asinghani/ibm-5151-controller/README.md

# IBM 5151 Controller

Building a VT100 emulator out of an old IBM 5151 monitor and an FPGA
