asinghani/ibm-5151-controller/pcb/3d/front.png

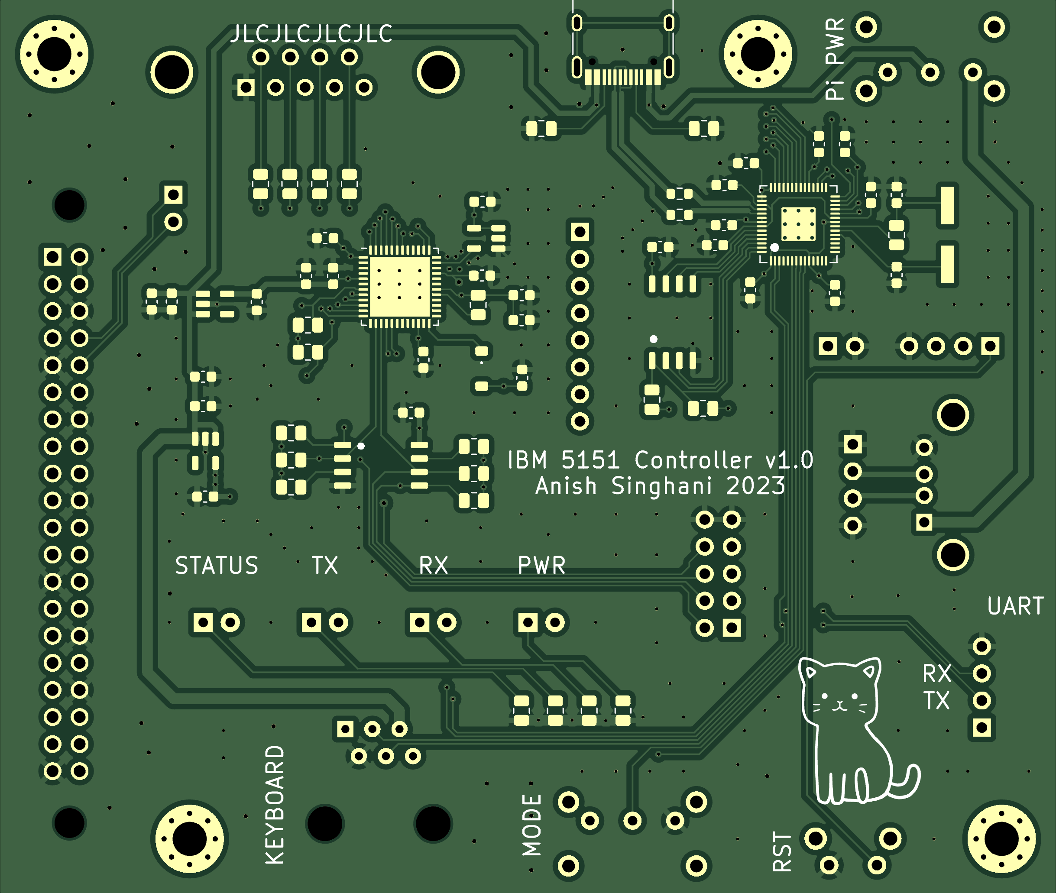
pcb/3d/front.png
