asinghani/ibm-5151-controller/pcb/3d/rear.png

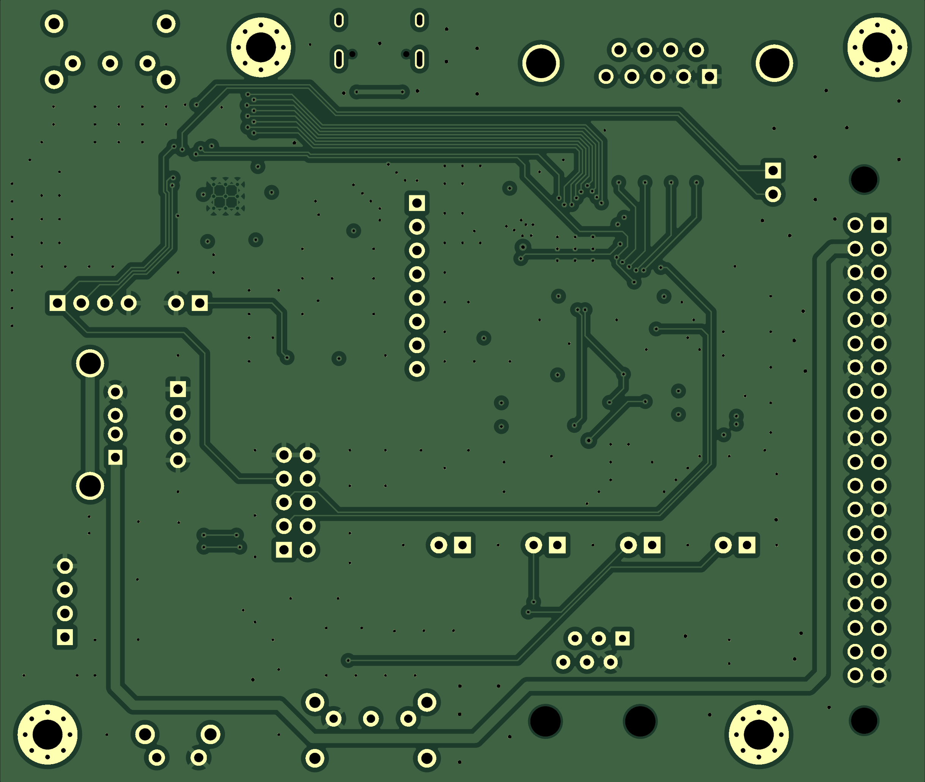
pcb/3d/rear.png
