asinghani/ibm-5151-controller/pcb/parts/Amphenol_54601/Amphenol_54601.STEP

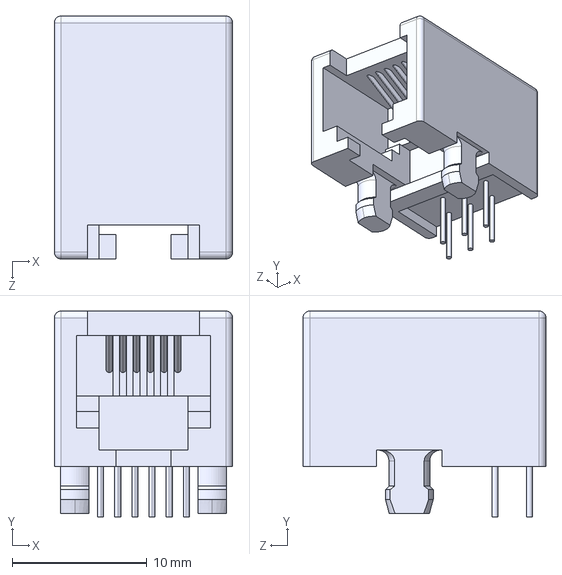
[picture p3: CAD file, 2023-10-15]
pcb/parts/Amphenol_54601/Amphenol_54601.STEP
13.2 x 15.2 x 18.0 mm
