asinghani/ibm-5151-controller/pcb/parts/ECS-120-20-3X-TR/ECS-120-20-3X-TR.step

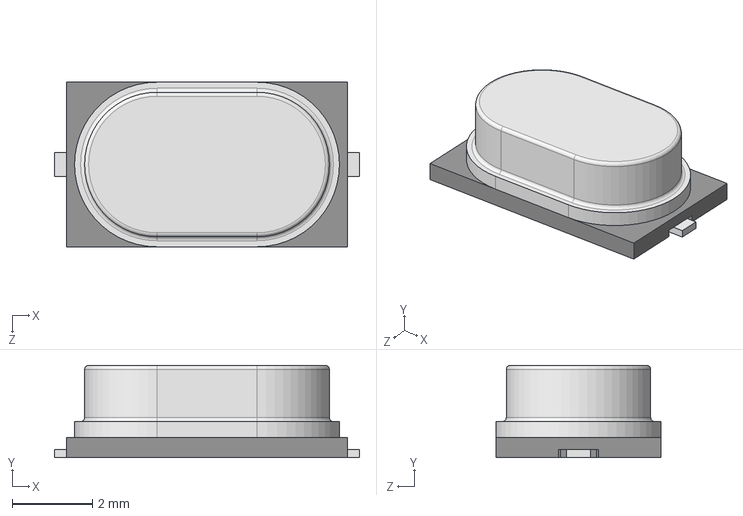
[picture p4: CAD file, 2023-10-15]
pcb/parts/ECS-120-20-3X-TR/ECS-120-20-3X-TR.step
7.60 x 2.30 x 4.10 mm
