asinghani/ibm-5151-controller/pcb/parts/Raspberry_Pi_Zero_W/RaspberryPiZeroW.STEP

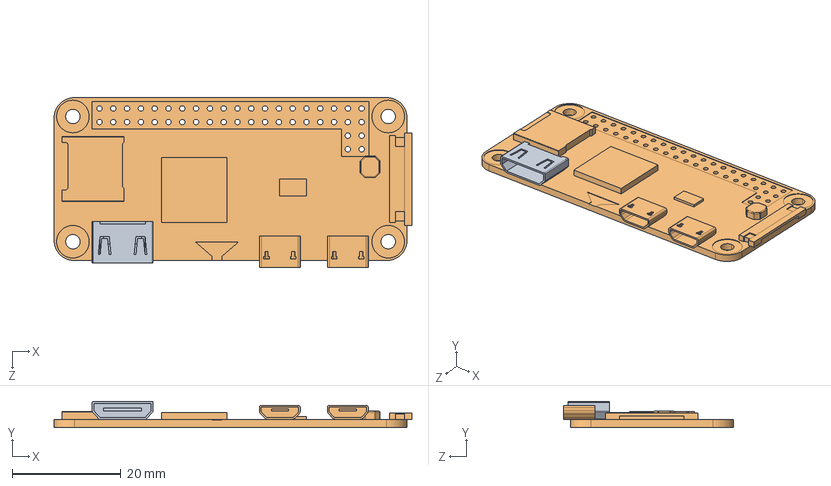
[picture p5: CAD file, 2023-10-15]
pcb/parts/Raspberry_Pi_Zero_W/RaspberryPiZeroW.STEP
65.9 x 4.80 x 31.2 mm
