asinghani/ibm-5151-controller/experimental/fonts/all_chars.png

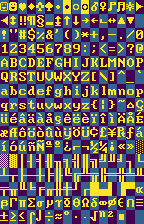
experimental/fonts/all_chars.png
