asinghani/ibm-5151-controller/experimental/fonts/all_chars_inv.png

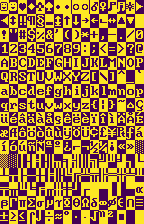
experimental/fonts/all_chars_inv.png
