asinghani/ibm-5151-controller/experimental/fonts/cow.png

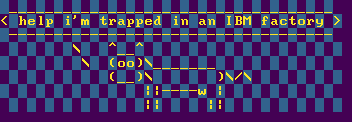
experimental/fonts/cow.png
