asinghani/ibm-5151-controller/gateware/chisel/tests/image1.png

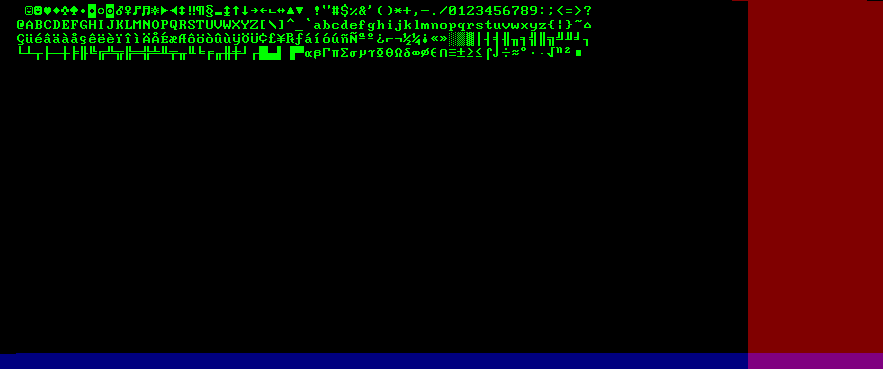
gateware/chisel/tests/image1.png
