asinghani/ibm-5151-controller/pcb/ibm-5151-pcb.kicad_pcb

## KiCad design pcb/ibm-5151-pcb.kicad_pcb (2023-12-21)

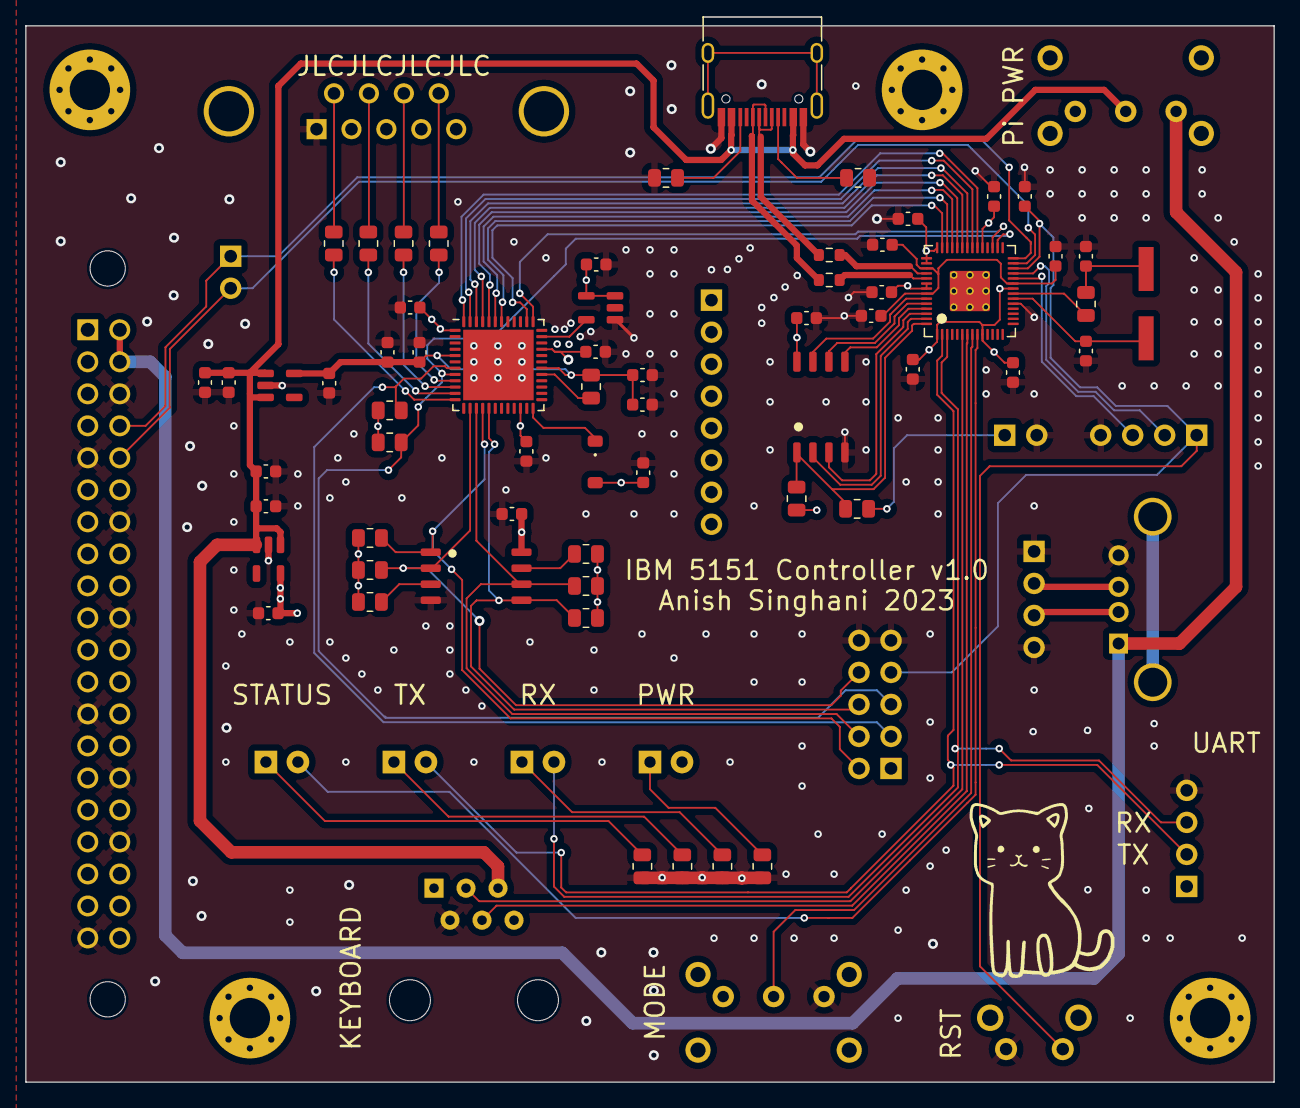
[picture p10: board ibm-5151-pcb.kicad_pcb from above]

Board: 4 copper layers, 99.1 x 83.8 mm, 84 parts (0 on the bottom side), 67 nets.

Parts:
C1, C2, C13: 10u; C_0603_1608Metric
C3, C4, C5, C6, C22, C26: 1u; C_0603_1608Metric
C7, C8, C9, C10, C11, C12, C15, C16, C20, C21, C23, C24, C25, C27, C28: 100n; C_0603_1608Metric
C14: 10n; C_0603_1608Metric
C17, C18: 27p; C_0603_1608Metric
C19: 0.1u; C_0603_1608Metric
D1: MBR130; D_SOD-123
D2: RXLED; LED_D5.0mm
D3: TXLED; LED_D5.0mm
D4: STLED; LED_D5.0mm
D5: PWRLED; LED_D5.0mm
H1, H2, H3, H4: MountingHole; MountingHole_3.2mm_M3_Pad_Via
IC1: Raspberry Pi Zero W; RASPBERRYPIZEROWV13
J2: USB_USER; USB_C_Receptacle_HRO_TYPE-C-31-M-12
J3: BOOT; PinHeader_1x02_P2.54mm_Vertical
J4: RP_DEBUG; PinHeader_1x04_P2.54mm_Vertical
J5: FPGA_IF_TP; PinHeader_1x08_P2.54mm_Vertical
J6: UART_HDR; PinSocket_1x04_P2.54mm_Horizontal
J7: KBD_CONN; RJ12_Amphenol_54601
J8: DE9_Receptacle; DSUB-9_Female_Horizontal_P2.77x2.84mm_EdgePinOffset7.70mm_H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
J9: NET_DBG; PinHeader_1x02_P2.54mm_Vertical
J10: USB_A; USB_A_Molex_67643_Horizontal
J11: USB_HDR; PinHeader_1x04_P2.54mm_Vertical
J12: FPGA_DEBUG; PinHeader_2x05_P2.54mm_Vertical
R1, R2, R3, R4, R5, R6: 10K; R_0805_2012Metric
R7, R8: 2K2; R_0805_2012Metric
R9, R21, R22, R23: 10R; R_0805_2012Metric
R10, R11: 5K1; R_0805_2012Metric
R12, R14, R17, R18, R19, R20: 1k; R_0805_2012Metric
R13: 10k, DNF; R_0805_2012Metric
R15, R16: 27R; R_0603_1608Metric
R24: 100R; R_0805_2012Metric
SW1: RP_RST; SW_Tactile_SPST_Angled_PTS645Vx58-2LFS
SW2, SW3: SW_SPDT; SW_E-Switch_EG1224_SPDT_Angled
U1: MIC5504-1.2YM5; SOT-23-5
U2: MIC5504-3.3YM5; SOT-23-5
U3: W25Q32JVSS; SOIC-8_5.23x5.23mm_P1.27mm
U4: W25Q128JVS; SOIC-8_5.23x5.23mm_P1.27mm
U5: ICE40UP5K-SG48ITR; QFN-48-1EP_7x7mm_P0.5mm_EP5.6x5.6mm
U6: RP2040; RP2040-QFN-56
X1: SiT2001BI-S2-33E-12.000000G; SOT-23-5
Y1: ECS-120-20-3X-TR; XTAL_ECS-120-20-3X-TR

Connections:
+1V2: C5.1, C12.1, C13.1, C14.1, C15.1, R24.2, U1.5 (VOUT), U5.5 (VCC), U5.30 (VCC)
+3V3: C6.1, C7.2, C8.1, C9.1, C10.1, C11.1, C16.1, C23.1, C24.1, C25.1, C26.1, C27.1, C28.2, D1.2 (A), D5.2 (A), J6.1, J12.1, R1.1, R2.1, R3.1, R4.1, R5.1, R6.1, R7.1, R8.1, R13.1, SW2.1 (A), U2.5 (VOUT), U3.8 (VCC), U4.8 (VCC), U5.1 (VCCIO_2), U5.22 (SPI_VCCIO1), U5.33 (VCCIO_0), U6.1 (IOVDD), U6.10 (IOVDD), U6.22 (IOVDD), U6.33 (IOVDD), U6.42 (IOVDD), U6.43 (ADC_AVDD), U6.44 (VREG_IN), U6.48 (USB_VDD), U6.49 (IOVDD), X1.3 (OE), X1.4 (Vcc)
+5V: C1.1, C2.1, C3.1, C4.1, J2.A4 (VBUS), J2.A9 (VBUS), J2.B4 (VBUS), J2.B9 (VBUS), J7.5, SW3.2 (B), U1.1 (VIN), U1.3 (EN), U2.1 (VIN), U2.3 (EN)
FPGA_CSn: J12.2, R1.2, U3.1 (~CS), U5.16 (IOB_35b_SPI_SS)
FPGA_DONE: J12.3, R8.2, U5.7 (CDONE)
FPGA_IF_0: J5.1, U5.48 (IOB_4a), U6.34 (GPIO22)
FPGA_IF_1: J5.2, U5.47 (IOB_2a), U6.35 (GPIO23)
FPGA_IF_2: J5.3, U5.46 (IOB_0a), U6.36 (GPIO24)
FPGA_IF_3: J5.4, U5.45 (IOB_5b), U6.37 (GPIO25)
FPGA_IF_4: J5.5, U5.44 (IOB_3b_G6), U6.38 (GPIO26_ADC0)
FPGA_IF_5: J5.6, U5.43 (IOT_49a), U6.39 (GPIO27_ADC1)
FPGA_IF_6: J5.7, U5.42 (IOT_51a), U6.40 (GPIO28_ADC2)
FPGA_IF_7: J5.8, U5.38 (IOT_50b), U6.41 (GPIO29_ADC3)
FPGA_IF_RST: U5.37 (IOT_45a_G1), U6.31 (GPIO20)
FPGA_MISO: J12.8, R4.2, U3.2 (DO(IO1)), U5.14 (IOB_32a_SPI_SO)
FPGA_MOSI: J12.6, R3.2, U3.5 (DI(IO0)), U5.17 (IOB_33b_SPI_SI)
FPGA_OSC: U5.35 (IOT_46b_G0), X1.5 (OUT)
FPGA_RSTn: J12.5, R7.2, U5.8 (~CRESET), U6.30 (GPIO19)
FPGA_SCK: J12.4, R2.2, U3.6 (CLK), U5.15 (IOB_34a_SPI_SCK)
GND: C1.2, C2.2, C3.2, C4.2, C5.2, C6.2, C7.1, C8.2, C9.2, C10.2, C11.2, C12.2, C13.2, C14.2, C15.2, C16.2, C17.2, C18.2, C19.2, C20.2, C21.2, C22.2, C23.2, C24.2, C25.2, C26.2, C27.2, C28.1, IC1.6 (GND_1), IC1.9 (GND_2), IC1.14 (GND_3), IC1.20 (GND_4), IC1.25 (GND_5), IC1.30 (GND_6), IC1.34 (GND_7), IC1.39 (GND_8), J2.A1 (GND), J2.A12 (GND), J2.B1 (GND), J2.B12 (GND), J3.2, J4.4, J6.4, J7.2, J8.1, J8.2, J10.4 (GND), J11.1, J11.4, J12.9, J12.10, R10.2, R11.2, R17.2, R18.2, R19.2, R20.2, SW1.2, SW2.3 (C), U1.2 (GND), U2.2 (GND), U3.4 (GND), U4.4 (GND), U5.49 (GND), U6.19 (TESTEN), U6.57 (GND), X1.1 (GND)
KBD_RX: J7.4, U6.7 (GPIO5)
KBD_TX: J7.3, U6.6 (GPIO4)
LED_STATUS: D4.2 (A), U6.9 (GPIO7)
NET_RX: IC1.8 (GPIO_14/[UART]_TXD0), J9.1, U6.28 (GPIO17)
NET_TX: IC1.10 (GPIO_15/[UART]_RXD0), J9.2, U6.27 (GPIO16)
unnamed: C18.1, R14.2, Y1.2
unnamed: D1.1 (K), U5.24 (VPP_2V5)
unnamed: D2.1 (K), R17.1
unnamed: D3.1 (K), R18.1
unnamed: D4.1 (K), R19.1
unnamed: D5.1 (K), R20.1
unnamed: J2.A5 (CC1), R10.1
unnamed: J2.B5 (CC2), R11.1
unnamed: J8.6, R9.2
unnamed: J8.7, R21.2
unnamed: J8.8, R22.2
unnamed: J8.9, R23.2
unnamed: J10.3 (D+), J11.2
unnamed: J10.2 (D-), J11.3
unnamed: R5.2, U3.3 (IO2)
unnamed: R6.2, U3.7 (IO3)
unnamed: R24.1, U5.29 (VCCPLL)
unnamed: R16.2, U6.46 (USB_DM)
unnamed: R15.2, U6.47 (USB_DP)
unnamed: C20.1, C21.1, C22.1, U6.23 (DVDD), U6.45 (VREG_VOUT), U6.50 (DVDD)
unnamed: C17.1, U6.20 (XIN), Y1.1
unnamed: R14.1, U6.21 (XOUT)
RP_BOOT: J3.1, R12.1
RP_CSn: R12.2, R13.2, U4.1 (~CS), U6.56 (QSPI_SS)
RP_RSTn: C19.1, J4.1, J12.7, SW1.1, U6.26 (RUN)
RP_SCK: U4.6 (CLK), U6.52 (QSPI_SCLK)
RP_SD0: U4.5 (DI(IO0)), U6.53 (QSPI_SD0)
RP_SD1: U4.2 (DO(IO1)), U6.55 (QSPI_SD1)
RP_SD2: U4.3 (IO2), U6.54 (QSPI_SD2)
RP_SD3: U4.7 (IO3), U6.51 (QSPI_SD3)
SWCLK: J4.3, U6.24 (SWCLK)
SWDIO: J4.2, U6.25 (SWD)
SW_SEL: SW2.2 (B), U6.8 (GPIO6)
UART_RX: D2.2 (A), J6.3, U6.3 (GPIO1)
UART_TX: D3.2 (A), J6.2, U6.2 (GPIO0)
USB_N: J2.A7 (D-), J2.B7 (D-), R16.1
USB_P: J2.A6 (D+), J2.B6 (D+), R15.1
USB_PWR: IC1.2 (+5V_1), IC1.4 (+5V_2), J10.1 (VBUS), SW3.1 (A)
VIDEO_HSYNC: R22.1, U5.10 (IOB_18a)
VIDEO_INTENS: R9.1, U5.12 (IOB_22a)
VIDEO_PIXEL: R21.1, U5.11 (IOB_20a)
VIDEO_VSYNC: R23.1, U5.9 (IOB_16a)
