asinghani/ibm-5151-controller/experimental/font.sv

module font (
    input logic [3:0] xidx,
    input logic [3:0] yidx,
    input logic [7:0] char,
    output logic pixel
);

    always_comb begin
        case (char)
            8'd32: pixel = 0;
            8'd33: pixel = ((xidx==3)&&(yidx==2))||((xidx==4)&&(yidx==2))||((xidx==2)&&(yidx==3))||((xidx==3)&&(yidx==3))||((xidx==4)&&(yidx==3))||((xidx==5)&&(yidx==3))||((xidx==2)&&(yidx==4))||((xidx==3)&&(yidx==4))||((xidx==4)&&(yidx==4))||((xidx==5)&&(yidx==4))||((xidx==2)&&(yidx==5))||((xidx==3)&&(yidx==5))||((xidx==4)&&(yidx==5))||((xidx==5)&&(yidx==5))||((xidx==3)&&(yidx==6))||((xidx==4)&&(yidx==6))||((xidx==3)&&(yidx==7))||((xidx==4)&&(yidx==7))||((xidx==3)&&(yidx==9))||((xidx==4)&&(yidx==9))||((xidx==3)&&(yidx==10))||((xidx==4)&&(yidx==10));
            8'd34: pixel = ((xidx==1)&&(yidx==1))||((xidx==2)&&(yidx==1))||((xidx==6)&&(yidx==1))||((xidx==7)&&(yidx==1))||((xidx==1)&&(yidx==2))||((xidx==2)&&(yidx==2))||((xidx==6)&&(yidx==2))||((xidx==7)&&(yidx==2))||((xidx==1)&&(yidx==3))||((xidx==2)&&(yidx==3))||((xidx==6)&&(yidx==3))||((xidx==7)&&(yidx==3))||((xidx==2)&&(yidx==4))||((xidx==6)&&(yidx==4));
            8'd35: pixel = ((xidx==2)&&(yidx==2))||((xidx==3)&&(yidx==2))||((xidx==5)&&(yidx==2))||((xidx==6)&&(yidx==2))||((xidx==2)&&(yidx==3))||((xidx==3)&&(yidx==3))||((xidx==5)&&(yidx==3))||((xidx==6)&&(yidx==3))||((xidx==1)&&(yidx==4))||((xidx==2)&&(yidx==4))||((xidx==3)&&(yidx==4))||((xidx==4)&&(yidx==4))||((xidx==5)&&(yidx==4))||((xidx==6)&&(yidx==4))||((xidx==7)&&(yidx==4))||((xidx==2)&&(yidx==5))||((xidx==3)&&(yidx==5))||((xidx==5)&&(yidx==5))||((xidx==6)&&(yidx==5))||((xidx==2)&&(yidx==6))||((xidx==3)&&(yidx==6))||((xidx==5)&&(yidx==6))||((xidx==6)&&(yidx==6))||((xidx==2)&&(yidx==7))||((xidx==3)&&(yidx==7))||((xidx==5)&&(yidx==7))||((xidx==6)&&(yidx==7))||((xidx==1)&&(yidx==8))||((xidx==2)&&(yidx==8))||((xidx==3)&&(yidx==8))||((xidx==4)&&(yidx==8))||((xidx==5)&&(yidx==8))||((xidx==6)&&(yidx==8))||((xidx==7)&&(yidx==8))||((xidx==2)&&(yidx==9))||((xidx==3)&&(yidx==9))||((xidx==5)&&(yidx==9))||((xidx==6)&&(yidx==9))||((xidx==2)&&(yidx==10))||((xidx==3)&&(yidx==10))||((xidx==5)&&(yidx==10))||((xidx==6)&&(yidx==10));
            8'd36: pixel = ((xidx==4)&&(yidx==0))||((xidx==5)&&(yidx==0))||((xidx==4)&&(yidx==1))||((xidx==5)&&(yidx==1))||((xidx==2)&&(yidx==2))||((xidx==3)&&(yidx==2))||((xidx==4)&&(yidx==2))||((xidx==5)&&(yidx==2))||((xidx==6)&&(yidx==2))||((xidx==1)&&(yidx==3))||((xidx==2)&&(yidx==3))||((xidx==6)&&(yidx==3))||((xidx==7)&&(yidx==3))||((xidx==1)&&(yidx==4))||((xidx==2)&&(yidx==4))||((xidx==7)&&(yidx==4))||((xidx==1)&&(yidx==5))||((xidx==2)&&(yidx==5))||((xidx==2)&&(yidx==6))||((xidx==3)&&(yidx==6))||((xidx==4)&&(yidx==6))||((xidx==5)&&(yidx==6))||((xidx==6)&&(yidx==6))||((xidx==6)&&(yidx==7))||((xidx==7)&&(yidx==7))||((xidx==1)&&(yidx==8))||((xidx==6)&&(yidx==8))||((xidx==7)&&(yidx==8))||((xidx==1)&&(yidx==9))||((xidx==2)&&(yidx==9))||((xidx==6)&&(yidx==9))||((xidx==7)&&(yidx==9))||((xidx==2)&&(yidx==10))||((xidx==3)&&(yidx==10))||((xidx==4)&&(yidx==10))||((xidx==5)&&(yidx==10))||((xidx==6)&&(yidx==10))||((xidx==4)&&(yidx==11))||((xidx==5)&&(yidx==11))||((xidx==4)&&(yidx==12))||((xidx==5)&&(yidx==12));
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
            8'd72: pixel = ((xidx==1)&&(yidx==2))||((xidx==2)&&(yidx==2))||((xidx==6)&&(yidx==2))||((xidx==7)&&(yidx==2))||((xidx==1)&&(yidx==3))||((xidx==2)&&(yidx==3))||((xidx==6)&&(yidx==3))||((xidx==7)&&(yidx==3))||((xidx==1)&&(yidx==4))||((xidx==2)&&(yidx==4))||((xidx==6)&&(yidx==4))||((xidx==7)&&(yidx==4))||((xidx==1)&&(yidx==5))||((xidx==2)&&(yidx==5))||((xidx==6)&&(yidx==5))||((xidx==7)&&(yidx==5))||((xidx==1)&&(yidx==6))||((xidx==2)&&(yidx==6))||((xidx==3)&&(yidx==6))||((xidx==4)&&(yidx==6))||((xidx==5)&&(yidx==6))||((xidx==6)&&(yidx==6))||((xidx==7)&&(yidx==6))||((xidx==1)&&(yidx==7))||((xidx==2)&&(yidx==7))||((xidx==6)&&(yidx==7))||((xidx==7)&&(yidx==7))||((xidx==1)&&(yidx==8))||((xidx==2)&&(yidx==8))||((xidx==6)&&(yidx==8))||((xidx==7)&&(yidx==8))||((xidx==1)&&(yidx==9))||((xidx==2)&&(yidx==9))||((xidx==6)&&(yidx==9))||((xidx==7)&&(yidx==9))||((xidx==1)&&(yidx==10))||((xidx==2)&&(yidx==10))||((xidx==6)&&(yidx==10))||((xidx==7)&&(yidx==10));
            8'd73: pixel = ((xidx==2)&&(yidx==2))||((xidx==3)&&(yidx==2))||((xidx==4)&&(yidx==2))||((xidx==5)&&(yidx==2))||((xidx==3)&&(yidx==3))||((xidx==4)&&(yidx==3))||((xidx==3)&&(yidx==4))||((xidx==4)&&(yidx==4))||((xidx==3)&&(yidx==5))||((xidx==4)&&(yidx==5))||((xidx==3)&&(yidx==6))||((xidx==4)&&(yidx==6))||((xidx==3)&&(yidx==7))||((xidx==4)&&(yidx==7))||((xidx==3)&&(yidx==8))||((xidx==4)&&(yidx==8))||((xidx==3)&&(yidx==9))||((xidx==4)&&(yidx==9))||((xidx==2)&&(yidx==10))||((xidx==3)&&(yidx==10))||((xidx==4)&&(yidx==10))||((xidx==5)&&(yidx==10));
            8'd74: pixel = ((xidx==4)&&(yidx==2))||((xidx==5)&&(yidx==2))||((xidx==6)&&(yidx==2))||((xidx==7)&&(yidx==2))||((xidx==5)&&(yidx==3))||((xidx==6)&&(yidx==3))||((xidx==5)&&(yidx==4))||((xidx==6)&&(yidx==4))||((xidx==5)&&(yidx==5))||((xidx==6)&&(yidx==5))||((xidx==5)&&(yidx==6))||((xidx==6)&&(yidx==6))||((xidx==5)&&(yidx==7))||((xidx==6)&&(yidx==7))||((xidx==1)&&(yidx==8))||((xidx==2)&&(yidx==8))||((xidx==5)&&(yidx==8))||((xidx==6)&&(yidx==8))||((xidx==1)&&(yidx==9))||((xidx==2)&&(yidx==9))||((xidx==5)&&(yidx==9))||((xidx==6)&&(yidx==9))||((xidx==2)&&(yidx==10))||((xidx==3)&&(yidx==10))||((xidx==4)&&(yidx==10))||((xidx==5)&&(yidx==10));
            8'd75: pixel = ((xidx==1)&&(yidx==2))||((xidx==2)&&(yidx==2))||((xidx==3)&&(yidx==2))||((xidx==6)&&(yidx==2))||((xidx==7)&&(yidx==2))||((xidx==2)&&(yidx==3))||((xidx==3)&&(yidx==3))||((xidx==6)&&(yidx==3))||((xidx==7)&&(yidx==3))||((xidx==2)&&(yidx==4))||((xidx==3)&&(yidx==4))||((xidx==5)&&(yidx==4))||((xidx==6)&&(yidx==4))||((xidx==2)&&(yidx==5))||((xidx==3)&&(yidx==5))||((xidx==5)&&(yidx==5))||((xidx==6)&&(yidx==5))||((xidx==2)&&(yidx==6))||((xidx==3)&&(yidx==6))||((xidx==4)&&(yidx==6))||((xidx==5)&&(yidx==6))||((xidx==2)&&(yidx==7))||((xidx==3)&&(yidx==7))||((xidx==5)&&(yidx==7))||((xidx==6)&&(yidx==7))||((xidx==2)&&(yidx==8))||((xidx==3)&&(yidx==8))||((xidx==5)&&(yidx==8))||((xidx==6)&&(yidx==8))||((xidx==2)&&(yidx==9))||((xidx==3)&&(yidx==9))||((xidx==6)&&(yidx==9))||((xidx==7)&&(yidx==9))||((xidx==1)&&(yidx==10))||((xidx==2)&&(yidx==10))||((xidx==3)&&(yidx==10))||((xidx==6)&&(yidx==10))||((xidx==7)&&(yidx==10));
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
            8'd95: pixel = ((xidx==0)&&(yidx==12))||((xidx==1)&&(yidx==12))||((xidx==2)&&(yidx==12))||((xidx==3)&&(yidx==12))||((xidx==4)&&(yidx==12))||((xidx==5)&&(yidx==12))||((xidx==6)&&(yidx==12))||((xidx==7)&&(yidx==12));
            8'd96: pixel = ((xidx==3)&&(yidx==0))||((xidx==4)&&(yidx==0))||((xidx==3)&&(yidx==1))||((xidx==4)&&(yidx==1))||((xidx==4)&&(yidx==2))||((xidx==5)&&(yidx==2));
            8'd97: pixel = ((xidx==2)&&(yidx==5))||((xidx==3)&&(yidx==5))||((xidx==4)&&(yidx==5))||((xidx==5)&&(yidx==5))||((xidx==5)&&(yidx==6))||((xidx==6)&&(yidx==6))||((xidx==2)&&(yidx==7))||((xidx==3)&&(yidx==7))||((xidx==4)&&(yidx==7))||((xidx==5)&&(yidx==7))||((xidx==6)&&(yidx==7))||((xidx==1)&&(yidx==8))||((xidx==2)&&(yidx==8))||((xidx==5)&&(yidx==8))||((xidx==6)&&(yidx==8))||((xidx==1)&&(yidx==9))||((xidx==2)&&(yidx==9))||((xidx==5)&&(yidx==9))||((xidx==6)&&(yidx==9))||((xidx==2)&&(yidx==10))||((xidx==3)&&(yidx==10))||((xidx==4)&&(yidx==10))||((xidx==6)&&(yidx==10))||((xidx==7)&&(yidx==10));
            8'd98: pixel = ((xidx==1)&&(yidx==2))||((xidx==2)&&(yidx==2))||((xidx==3)&&(yidx==2))||((xidx==2)&&(yidx==3))||((xidx==3)&&(yidx==3))||((xidx==2)&&(yidx==4))||((xidx==3)&&(yidx==4))||((xidx==2)&&(yidx==5))||((xidx==3)&&(yidx==5))||((xidx==4)&&(yidx==5))||((xidx==5)&&(yidx==5))||((xidx==2)&&(yidx==6))||((xidx==3)&&(yidx==6))||((xidx==5)&&(yidx==6))||((xidx==6)&&(yidx==6))||((xidx==2)&&(yidx==7))||((xidx==3)&&(yidx==7))||((xidx==6)&&(yidx==7))||((xidx==7)&&(yidx==7))||((xidx==2)&&(yidx==8))||((xidx==3)&&(yidx==8))||((xidx==6)&&(yidx==8))||((xidx==7)&&(yidx==8))||((xidx==2)&&(yidx==9))||((xidx==3)&&(yidx==9))||((xidx==6)&&(yidx==9))||((xidx==7)&&(yidx==9))||((xidx==1)&&(yidx==10))||((xidx==2)&&(yidx==10))||((xidx==4)&&(yidx==10))||((xidx==5)&&(yidx==10))||((xidx==6)&&(yidx==10));
            8'd99: pixel = ((xidx==2)&&(yidx==5))||((xidx==3)&&(yidx==5))||((xidx==4)&&(yidx==5))||((xidx==5)&&(yidx==5))||((xidx==6)&&(yidx==5))||((xidx==1)&&(yidx==6))||((xidx==2)&&(yidx==6))||((xidx==6)&&(yidx==6))||((xidx==7)&&(yidx==6))||((xidx==1)&&(yidx==7))||((xidx==2)&&(yidx==7))||((xidx==1)&&(yidx==8))||((xidx==2)&&(yidx==8))||((xidx==1)&&(yidx==9))||((xidx==2)&&(yidx==9))||((xidx==6)&&(yidx==9))||((xidx==7)&&(yidx==9))||((xidx==2)&&(yidx==10))||((xidx==3)&&(yidx==10))||((xidx==4)&&(yidx==10))||((xidx==5)&&(yidx==10))||((xidx==6)&&(yidx==10));
            8'd100: pixel = ((xidx==4)&&(yidx==2))||((xidx==5)&&(yidx==2))||((xidx==6)&&(yidx==2))||((xidx==5)&&(yidx==3))||((xidx==6)&&(yidx==3))||((xidx==5)&&(yidx==4))||((xidx==6)&&(yidx==4))||((xidx==3)&&(yidx==5))||((xidx==4)&&(yidx==5))||((xidx==5)&&(yidx==5))||((xidx==6)&&(yidx==5))||((xidx==2)&&(yidx==6))||((xidx==3)&&(yidx==6))||((xidx==5)&&(yidx==6))||((xidx==6)&&(yidx==6))||((xidx==1)&&(yidx==7))||((xidx==2)&&(yidx==7))||((xidx==5)&&(yidx==7))||((xidx==6)&&(yidx==7))||((xidx==1)&&(yidx==8))||((xidx==2)&&(yidx==8))||((xidx==5)&&(yidx==8))||((xidx==6)&&(yidx==8))||((xidx==1)&&(yidx==9))||((xidx==2)&&(yidx==9))||((xidx==5)&&(yidx==9))||((xidx==6)&&(yidx==9))||((xidx==2)&&(yidx==10))||((xidx==3)&&(yidx==10))||((xidx==4)&&(yidx==10))||((xidx==6)&&(yidx==10))||((xidx==7)&&(yidx==10));
            8'd101: pixel = ((xidx==2)&&(yidx==5))||((xidx==3)&&(yidx==5))||((xidx==4)&&(yidx==5))||((xidx==5)&&(yidx==5))||((xidx==6)&&(yidx==5))||((xidx==1)&&(yidx==6))||((xidx==2)&&(yidx==6))||((xidx==6)&&(yidx==6))||((xidx==7)&&(yidx==6))||((xidx==1)&&(yidx==7))||((xidx==2)&&(yidx==7))||((xidx==3)&&(yidx==7))||((xidx==4)&&(yidx==7))||((xidx==5)&&(yidx==7))||((xidx==6)&&(yidx==7))||((xidx==7)&&(yidx==7))||((xidx==1)&&(yidx==8))||((xidx==2)&&(yidx==8))||((xidx==1)&&(yidx==9))||((xidx==2)&&(yidx==9))||((xidx==6)&&(yidx==9))||((xidx==7)&&(yidx==9))||((xidx==2)&&(yidx==10))||((xidx==3)&&(yidx==10))||((xidx==4)&&(yidx==10))||((xidx==5)&&(yidx==10))||((xidx==6)&&(yidx==10));
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
            8'd125: pixel = ((xidx==1)&&(yidx==2))||((xidx==2)&&(yidx==2))||((xidx==3)&&(yidx==2))||((xidx==3)&&(yidx==3))||((xidx==4)&&(yidx==3))||((xidx==3)&&(yidx==4))||((xidx==4)&&(yidx==4))||((xidx==3)&&(yidx==5))||((xidx==4)&&(yidx==5))||((xidx==4)&&(yidx==6))||((xidx==5)&&(yidx==6))||((xidx==6)&&(yidx==6))||((xidx==3)&&(yidx==7))||((xidx==4)&&(yidx==7))||((xidx==3)&&(yidx==8))||((xidx==4)&&(yidx==8))||((xidx==3)&&(yidx==9))||((xidx==4)&&(yidx==9))||((xidx==1)&&(yidx==10))||((xidx==2)&&(yidx==10))||((xidx==3)&&(yidx==10));
            8'd126: pixel = ((xidx==2)&&(yidx==2))||((xidx==3)&&(yidx==2))||((xidx==4)&&(yidx==2))||((xidx==6)&&(yidx==2))||((xidx==7)&&(yidx==2))||((xidx==1)&&(yidx==3))||((xidx==2)&&(yidx==3))||((xidx==4)&&(yidx==3))||((xidx==5)&&(yidx==3))||((xidx==6)&&(yidx==3));
            default: pixel = 0;
        endcase
    end

endmodule

module font_cp437 (
    input logic [3:0] xidx,
    input logic [3:0] yidx,
    input logic [7:0] char,
    output logic pixel
);
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
