asinghani/ibm-5151-controller/experimental/uart_tx.sv

`default_nettype none
// UART Transmitter (8/N/1)
module uart_tx
#(
    parameter CLK_FREQ = 250000,
    parameter BAUD = 9600
)
(
    output wire o_ready,
    output reg o_out,

    input wire [7:0] i_data,
    input wire i_valid,

    input wire i_rst,
    input wire i_clk
); 

localparam _CLKS_PER_BIT = CLK_FREQ / BAUD;
localparam [$clog2(_CLKS_PER_BIT * 2):0] CLKS_PER_BIT = _CLKS_PER_BIT[$clog2(_CLKS_PER_BIT * 2):0];

reg[($clog2(_CLKS_PER_BIT) + 1):0] counter;
reg [3:0] state = 0; // 0 = idle, 1 = start bit, 2-9 = data bits, 10 = end bit

reg [7:0] data_send; // Buffer the data in case it changes while sending

assign o_ready = (state == 0);

always_ff @(posedge i_clk) begin
    counter <= 10; // Set counter to default value when idle

    if (i_rst) begin
        state <= 0;
        data_send <= 0;
    end
    else if (state == 0) begin
        // Start transmission
        if(i_valid) begin
            state <= 1;
            data_send <= i_data;

            /* verilator lint_off WIDTH */
            counter <= CLKS_PER_BIT;
            /* verilator lint_on WIDTH */
        end

        // Else stay in idle
    end
    else if (counter == 0) begin
        // End bit
        if(state == 10) begin
            state <= 0;
            `ifdef DEBUG
                $display("TRANSMIT FINISHED");
            `endif
        end

        else begin
            state <= state + 1;
            /* verilator lint_off WIDTH */
            if (state == 10) begin
                counter <= CLKS_PER_BIT - 1;
            end
            else begin
                counter <= CLKS_PER_BIT;
            end
            /* verilator lint_on WIDTH */
        end
    end
    else begin
        counter <= counter - 1;
    end
end

always_comb begin
    if(state == 0) begin
        o_out = 1;
    end
    else if(state == 1) begin
        o_out = 0;
    end
    else if(state == 10) begin
        o_out = 1;
    end
    else begin
        o_out = data_send[state - 2];
    end
end

endmodule
