asinghani/ibm-5151-controller/(commit log)

2023-10-15 finish pcb layout
    [Amphenol_54601.STEP, ECS-120-20-3X-TR.step, RaspberryPiZeroW.STEP, fpga_driver.kicad_sch, ibm-5151-pcb.kicad_pcb, ibm-5151-pcb.kicad_sch, rp2040_mcu.kicad_sch]
2023-12-21 Gateware updates, improve Scala build config
    [ibm-5151-pcb.kicad_pcb]
